mhismail3/Sensory-Feedback-Mechanism-for-Prosthetic-Devices/CAD Files for Sensor Testing/For Testing Fingertips/FingerTipTesting.stl

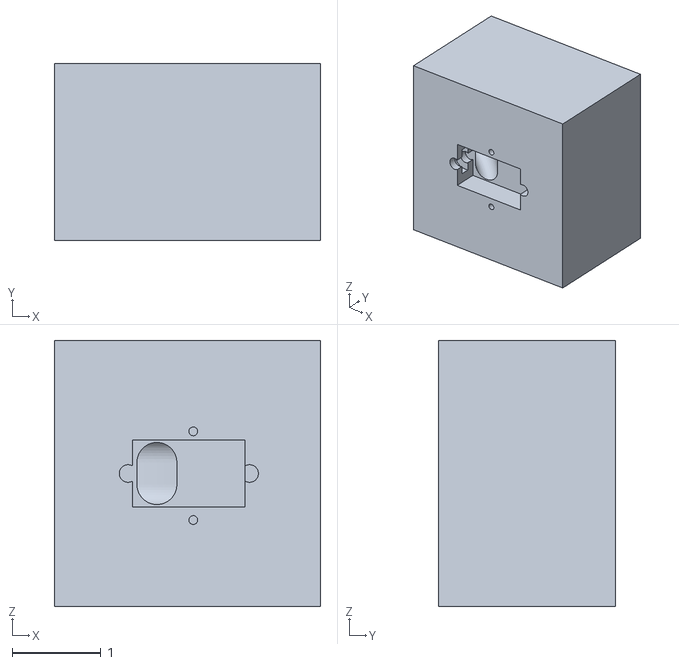
[picture p9: CAD file, 2017-03-24]
CAD Files for Sensor Testing/For Testing Fingertips/FingerTipTesting.stl
3.00 x 2.00 x 3.00
