mhismail3/Sensory-Feedback-Mechanism-for-Prosthetic-Devices/Part Files and Code/DistFinger_Mold.stl

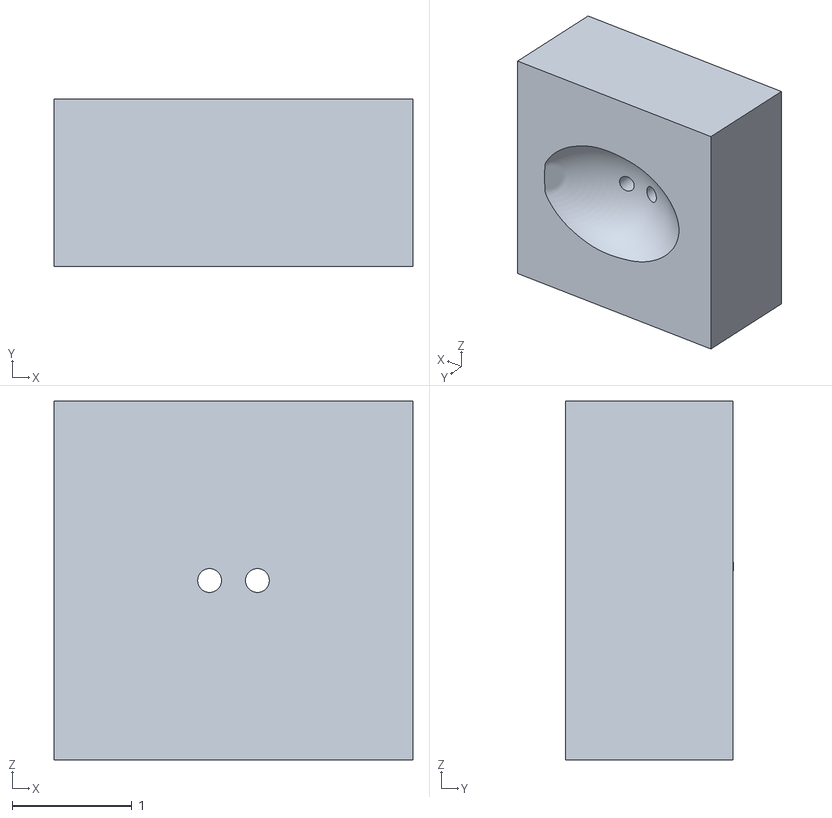
[picture p10: CAD file, 2017-03-24]
Part Files and Code/DistFinger_Mold.stl
3.00 x 1.40 x 3.00
