mhismail3/Sensory-Feedback-Mechanism-for-Prosthetic-Devices/CAD Files for Sensor Testing/For Testing Fingertips/finger_mount.stl

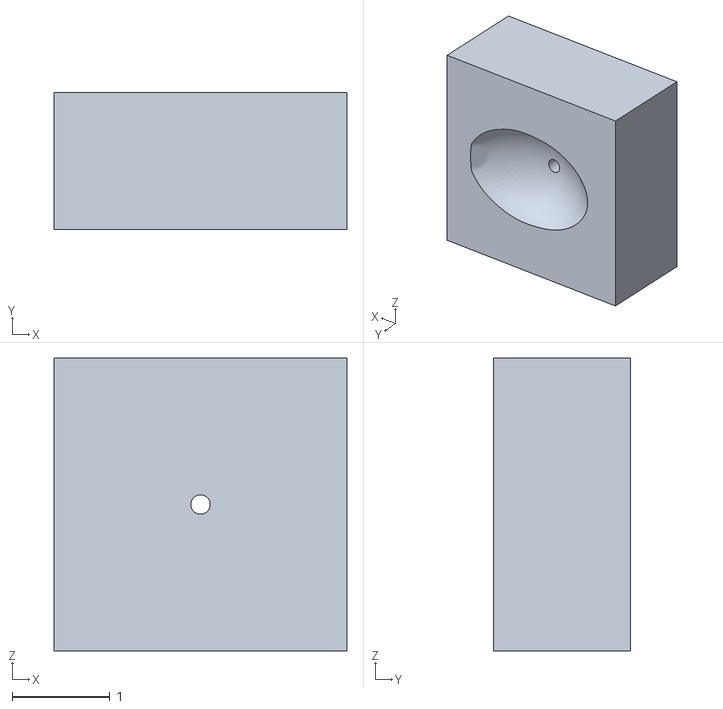
[picture p11: CAD file, 2017-03-24]
CAD Files for Sensor Testing/For Testing Fingertips/finger_mount.stl
3.00 x 1.40 x 3.00
