mhismail3/Sensory-Feedback-Mechanism-for-Prosthetic-Devices/Part Files and Code/DistFinger_Sensor.stl

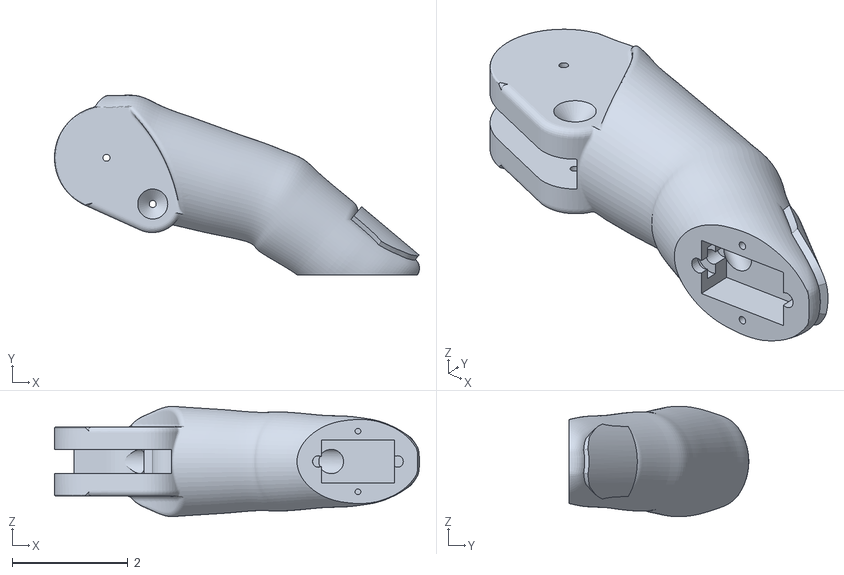
[picture p12: CAD file, 2017-03-24]
Part Files and Code/DistFinger_Sensor.stl
6.31 x 3.11 x 1.91
