mhismail3/Sensory-Feedback-Mechanism-for-Prosthetic-Devices/Part Files and Code/ProxFinger_Sensor.stl

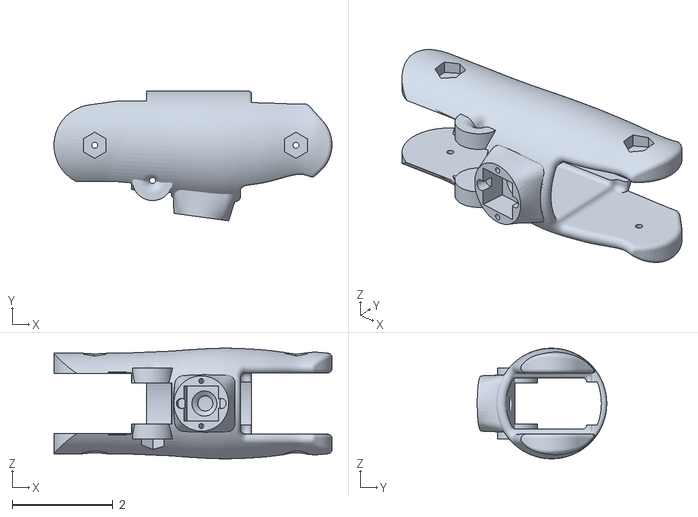
[picture p13: CAD file, 2017-03-24]
Part Files and Code/ProxFinger_Sensor.stl
5.53 x 2.58 x 2.20
