mhismail3/Sensory-Feedback-Mechanism-for-Prosthetic-Devices/(list of files, cad)

Other CAD files:
Part Files and Code/ProxFinger_Mold.stl
CAD Files for Sensor Testing/Finger Mold 2.iam
CAD Files for Sensor Testing/For Testing Fingertips/FingerTipTesting.ipt
CAD Files for Sensor Testing/For Testing Fingertips/finger_mount.ipt
CAD Files for Sensor Testing/Full Rubber Finger.ipt
CAD Files for Sensor Testing/Mold Half 1.ipt
CAD Files for Sensor Testing/Mold Half 2.ipt
Part Files and Code/DistFinger_Mold.ipt
Part Files and Code/DistFinger_Sensor.ipt
Part Files and Code/ProxFinger_Mold.ipt
Part Files and Code/ProxFinger_Sensor.ipt
